uvic-auvic/PCB-Livewire_Control_Board/README.md

# PCB-Livewire_Control_Board
Custom PCB designed by Miguel Manguerra in conjuction with the AUVIC electrical team. The main purpose of the board is to power the coil gun
that shoots torpedos on AUVIC's new submarine.
