uvic-auvic/PCB-Livewire_Control_Board/BOM/BOM/Bill of Materials-RailGun and Grabber Control Board.xlsx

Line # | Name | Description | Designator | Revision ID | Quantity | Manufacturer 1 | Manufacturer Part Number 1 | Manufacturer Lifecycle 1 | Supplier 1 | Supplier Part Number 1 | Supplier Unit Price 1 | Supplier Subtotal 1
 | CL10B104JB8NNNC | CAP CER 0.1UF 50V X7R 0603 | C1, C3, C8, C11, C14, C15, C16, C17, C18, C19 | CMP-00000-3 | 10 | Samsung | CL10B104JB8NNNC | Volume Production
 | CL21B105KBFNNNG | SAMSUNG ELECTRO-MECHANICS - CL21B105KBFNNNG - MLCC CAPACITORS | C2, C12 | CMP-00005-1 | 2 | Samsung | CL21B105KBFNNNG | Volume Production
 | 1uF 50V 0603 SMD, Ceramic | Capacitor, Ceramic, 50V, +/- 10%, 0603 SMD, X5R | C4_Gin1, C4_Gin2, C4_Gin3, C21, C22 | CMP-006-0028-1 | 5 | Samsung | CL10A105KB8NNNC | Volume Production
 | 0.1uF, 50V, 10%, X7R, 1608 | CAP CER 0.1UF 50V 10% X7R 1608 (0603) | C5_Gin1, C5_Gin2, C5_Gin3, C6_Gin1, C6_Gin2, C6_Gin3, C?_Gin1, C?_Gin2, C?_Gin3 | CMP-006-0008-1 | 9 | Samsung | CL10B104KB8SFNC | Volume Production
 | 10uF 50V 1206 SMD, Ceramic | Capacitor, Ceramic, 50V, +/- 10%, 1206 SMD, X5R | C7_Gin1, C7_Gin2, C7_Gin3 | CMP-006-0018-1 | 3 | Samsung | CL31A106KBHNNNE | Volume Production
 | 16pF Ceramic 50V 5% 0603 | Cap Ceramic 16pF 50V C0G 5% SMD 0603 125C Paper T/R | C9, C10 | CMP-00087-2 | 2 | Murata | GRM1885C1H160JA01D | Volume Production
 | 2.2uF, 50V, 0603 SMD, X5R, Ceramic | Capacitor, Ceramic, 50V, 10%, 0603 SMD, X5R | C13 | CMP-006-0030-1 | 1 | Murata | GRM188R61H225KE11D | Volume Production
 | CL31B106KBHNNNE | Cap Ceramic 10uF 50V X7R 10% Pad SMD 1206 125°C T/R | C20 | CMP-00004-1 | 1 | Samsung | CL31B106KBHNNNE | New Product
 | 1x2 Shrouded Right Angle | 02 MTE HDR SRRA LATCH | CN1 | CMP-00010-3 | 1 | TE Connectivity | 5-104935-5 | Volume Production
 | Header, Female, 2x2, RIght Angle, Pitch: 0.118" (3.00mm), THT | Connector Header Through Hole, Right Angle 4 position 0.118" (3.00mm) | CN2_Gin1, CN2_Gin2, CN2_Gin3 | CMP-005-0021-4 | 3 | Molex | 0430450402 | Volume Production
 | ST Debug Header 10-pin THT | CONN HEADER VERT 10POS 2.54MM | CN3 | CMP-00011-6 | 1 | Sullins | SBH11-PBPC-D05-ST-BK | Volume Production
 | Header, Male, 1x4, RA, Pitch 0.1" (2.54mm) | Connector Header Through Hole, Right Angle 4 position 0.100" (2.54mm) | CN4, CN5 | CMP-005-0029-3 | 2 | TE Connectivity | 5-104935-1 | Volume Production
 | 76825-0006 | CONNECTOR, HEADER, 6POS, 2ROW, 5.7MM; Product Range:Mega-Fit 76825 Series; Contact Termination Type:Through Hole; Gender:Header; No. of Contacts:6; Pitch Spacing:5.7mm; Contact Plating:Tin Plated Contacts; Contact Material:Copper | CN6 | CMP-00049-2 | 1 | Molex | 76825-0006 | Volume Production
 | TSSA5U50E3GCT-ND | Diode Schottky 50V 5A Surface Mount DO-214AC (SMA) | D1_Gin1, D1_Gin2, D1_Gin3 | CMP-057-0021-1 | 3 | Taiwan Semiconductor | TSSA5U50 E3G | Unknown
 | LSQ976-NR-1 | LED Red 645nm 2-Pin Chip 0603(1608Metric) T/R | D2 | CMP-00066-2 | 1 | Osram Opto | LSQ976-NR-1 | Volume Production
 | LBQ39E-N1OO-35-1 | LED BLUE DIFFUSED 0603 SMD | D3 | CMP-00063-3 | 1 | Osram Opto | LBQ39E-N1OO-35-1 | Volume Production
 | LT Q39G-Q1OO-25-1 | LED GREEN DIFFUSED 0603 SMD | D4, D6, D7, D8 | CMP-00064-3 | 4 | Osram Opto | LT Q39G-Q1OO-25-1 | Volume Production
 | CUS08F30,H3F | Diode Schottky 30V 800mA Surface Mount USC | D5 | CMP-057-0000-2 | 1 | Toshiba | CUS08F30,H3F | Volume Production
 | SMD Fuse, 2A, 63V, | SMD Fuse, 2A, 63V, | F? | CMP-027-0004-1 | 1 | Bel TRP | C1F2 | Volume Production
 | BLM18AG601SN1D | MURATA - BLM18AG601SN1D - Feritový Korálek, 0603 / 1608, 600 ohm, 500 mA, Série BLM18A, 0.38 ohm, ± 25% | FB1 | CMP-00016-1 | 1 | Murata | BLM18AG601SN1D | Volume Production
 | 1x2 Male Header |  | JP1, JP2, JP3 | CMP-004-0001-1 | 3 | Harwin | M20-9730246 | Volume Production
 | Mount_Hole_3mm | Mounting hold for M3 hex standoff | MH1, MH2, MH3, MH4 | CMP-004-0010-4 | 4
 | MOSFET N-Channel, 40V, 100A, 272W | MOSFET N-Channel, 40V, 100A, 272W, Enh-Mode | Q1_Gin1, Q1_Gin2, Q1_Gin3 | CMP-052-0019-1 | 3 | Nexperia | PSMN1R8-40YLC,115 | Unknown
 | RC0603FR-0733RL | Res Thick Film 0603 33 Ohm 1% 1/10W +/-100ppm/ßC Molded SMD Paper T/R | R1, R3 | CMP-00060-1 | 2 | Yageo | RC0603FR-0733RL | Volume Production
 | RC0603FR-07120RL | Res Thick Film 0603 120 Ohm 1% 0.1W(1/10W) ±100ppm/C Epoxy SMD T/R | R2 | CMP-00061-1 | 1 | Yageo | RC0603FR-07120RL | Volume Production
 | 78.7kR, 1%, 1/10W, 0603 | Res Thick Film 0603 78.7K Ohm 1% 1/10W 100ppm/C Molded SMD SMD Paper T/R | R4_Gin1, R4_Gin2, R4_Gin3 | CMP-00095-1 | 3 | Stackpole Electronics | RMCF0603FT78K7 | Volume Production
 | 100kR, 1%, 1/10W, 0603 SMD | 100kR, 1%, 1/10W, 0603 SMD | R5_Gin1, R5_Gin2, R5_Gin3, R6_Gin1, R6_Gin2, R6_Gin3, R7_Gin1, R7_Gin2, R7_Gin3 | CMP-047-0010-1 | 9 | Yageo | RC0603JR-07100KL | Volume Production
 | 10kR, 1%, 1/10W, 0603 SMD | 10kR, 1%, 1/10W, 0603 SMD | R8_Gin1, R8_Gin2, R8_Gin3, R13, R14, R16, R17, R20, R23, R24, R25 | CMP-047-0013-1 | 11 | Yageo Phycomp | RC0603FR-0710KL | Volume Production
 | 0R005, 1%, 3W, 2512 SMD | 0R005, 1%, 3W, 2512 SMD | R9_Gin1, R9_Gin2, R9_Gin3 | CMP-047-0004-1 | 3 | Bourns | CRE2512-FZ-R005E-3 | Volume Production
 | CRCW0603330RFKEA | Res Thick Film 0603 330 Ohm 1% 0.1W(1/10W) +/-100ppm/ßC Pad SMD Automotive T/R | R10 | CMP-00067-2 | 1 | Vishay | CRCW0603330RFKEA | Volume Production
 | 1kR, 1%, 1/10W , 0603, SMD | 1kR, 1%, 1/10W , 0603, SMD | R11, R26, R27, R28 | CMP-047-0024-1 | 4 | Yageo | RC0603FR-071KL | Volume Production
 | RC0603FR-07110RL | RES SMD 110 OHM 1% 1/10W 0603 | R12, R15, R31 | CMP-00069-1 | 3 | Yageo | RC0603FR-07110RL | Volume Production
 | ERJ-3EKF8252V | RES SMD 82.5K OHM 1% 1/10W 0603 | R18 | CMP-00085-1 | 1 | Panasonic | ERJ-3EKF8252V | Volume Production
 | 16kR, 1%, 1/10W, 0603 SMD | 16kR, 1%, 1/10W, 0603 SMD | R19 | CMP-047-0021-1 | 1 | Yageo | RC0603FR-0716KL | Volume Production
 | RC0603FR-0710KL | Res General Purpose Thick Film 0603 10K Ohm 1% 1/10W ±100ppm/°C Molded SMD Paper T/R | R21 | CMP-00037-1 | 1 | Yageo | RC0603FR-0710KL | Volume Production
 | 27kR, 1%, 1/10W, 0603 | Res Thick Film 0603 27K Ohm 1% 0.1W(1/10W) ±100ppm/C Pad SMD Automotive T/R | R22 | CMP-00090-2 | 1 | TE Connectivity | CRGCQ0603F27K | Unknown
 | CRCW06036K34FKEA | VISHAY CRCW06036K34FKEA. SMD Chip Resistor, Thick Film, 6.34 kohm, 75 V, 0603 [1608 Metric], 100 mW, 1%, CRCW Series | R29 | CMP-00072-1 | 1 | Vishay | CRCW06036K34FKEA | Volume Production
 | ERJ-3EKF5360V | SMD Chip Resistor, 0603 [1608 Metric], 536 ohm, ERJ3EK Series, 75 V, Thick Film, 100 mW | R30 | CMP-00071-1 | 1 | Panasonic | ERJ-3EKF5360V | Volume Production
 | 0R02, 1%, 2W, 2512 SMD | 0R02, 1%, 2W, 2512 SMD | R?_Gin1, R?_Gin2, R?_Gin3 | CMP-047-0006-1 | 3 | TE Connectivity | RLP73V3AR020FTDF | Unknown
 | 80.6kR, 1%, 1/10W, 0603 | Res Thick Film 0603 80.6K Ohm 1% 0.1W(1/10W) ±100ppm/C Molded SMD Automotive Paper T/R | R?_Gin1, R?_Gin2, R?_Gin3 | CMP-00098-1 | 3 | Vishay | CRCW060380K6FKEA | Volume Production
 | PTS645SL43SMTR92LFS | Black Switch Tactile N.O. SPST Round Button Gull Wing 0.05A 12VDC 100000Cycles 1.27N SMD T/R | SW1 | CMP-00077-1 | 1 | ITT C&K | PTS645SL43SMTR92LFS | Volume Production
 | PESD36VS2UT,215 | TVS DIODE 36V 60V SOT23 | TVS1, TVS2 | CMP-058-0000-2 | 2 | Nexperia | PESD36VS2UT,215 | Unknown
 | CAN Transceiver | 1/1 Transceiver Half CANbus 8-SO | U1 | CMP-032-0000-2 | 1 | NXP Semiconductors | TJA1042T/3,118 | Volume Production
 | Op amp 1.8-6V rail-to-rail (SOT23-5) | Op amp 1.8-6V rail-to-rail (SOT23-5) | U2_Gin1, U2_Gin2, U2_Gin3 | CMP-042-0002-1 | 3 | Microchip | MCP6001T-I/OT | Volume Production
 | MIC5014YM-TR | High-Side or Low-Side Gate Driver IC Non-Inverting 8-SOIC | U3_Gin1, U3_Gin2, U3_Gin3 | CMP-028-0000-2 | 3 | Microchip | MIC5014YM-TR | Volume Production
 | STM32F413RGT6 | STMICROELECTRONICS - STM32F413RGT6 - MCU, ARM CORTEX-M4, 100MHZ, LQFP-64 | U4 | CMP-00006-1 | 1 | STMicroelectronics | STM32F413RGT6 | Unknown
 | STM32F413RGT6 | STMICROELECTRONICS - STM32F413RGT6 - MCU, ARM CORTEX-M4, 100MHZ, LQFP-64 | U5 | CMP-00006-2 | 1 | STMicroelectronics | STM32F413RGT6 | Unknown
 | 3.3V 250mA Linear Reg LDO | IC REG LINEAR 3.3V 250MA SOT23-3 | U6 | CMP-00003-1 | 1 | Diodes | AP2138N-3.3TRG1 | Volume Production | Digi-Key | AP2138N-3.3TRG1
 | INA168, Current Sensor, High-Side, Analog | INA168, Current Sensor, High-Side, Analog | U?_Gin1, U?_Gin2, U?_Gin3 | CMP-048-0001-1 | 3 | Texas Instruments | INA168NA/3K | Volume Production
 | CRYSTAL 8.0MHZ 16PF SMD | 8MHz ±30ppm Crystal 16pF 80 Ohms 4-SMD, No Lead | X1 | CMP-00079-2 | 1 | IQD | LFXTAL026380REEL | Volume Production
