uvic-auvic/PCB-Livewire_Control_Board/PDF/RailGun and Grabber Control Board.PDF

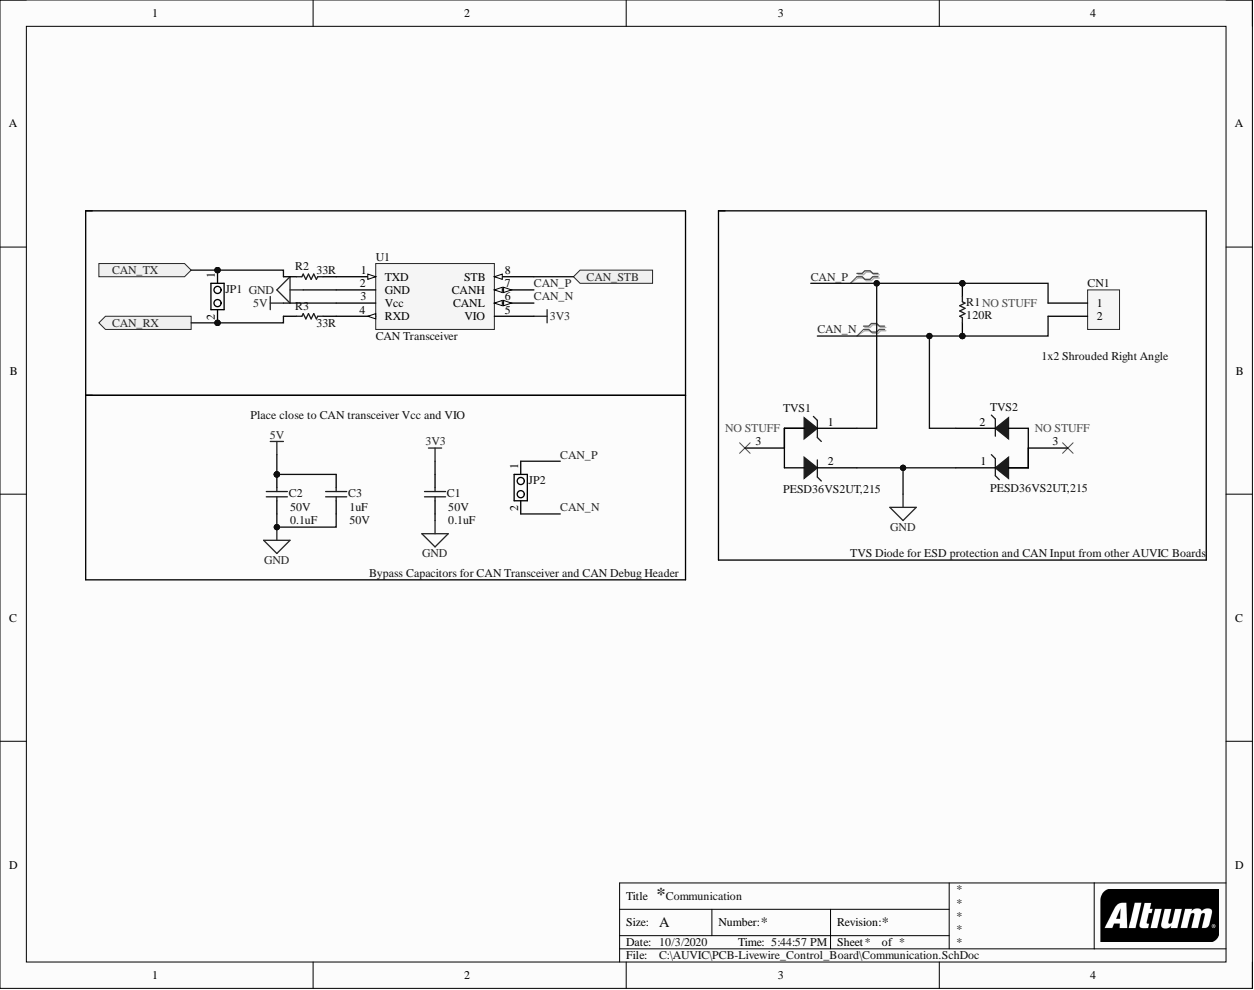
[picture p1: page 1]

Place close to CAN transceiver Vcc and VIO

TVS Diode for ESD protection and CAN Input from other AUVIC Boards

Bypass Capacitors for CAN Transceiver and CAN Debug Header

C:\AUVIC\PCB-Livewire_Control_Board\Communication.SchDoc

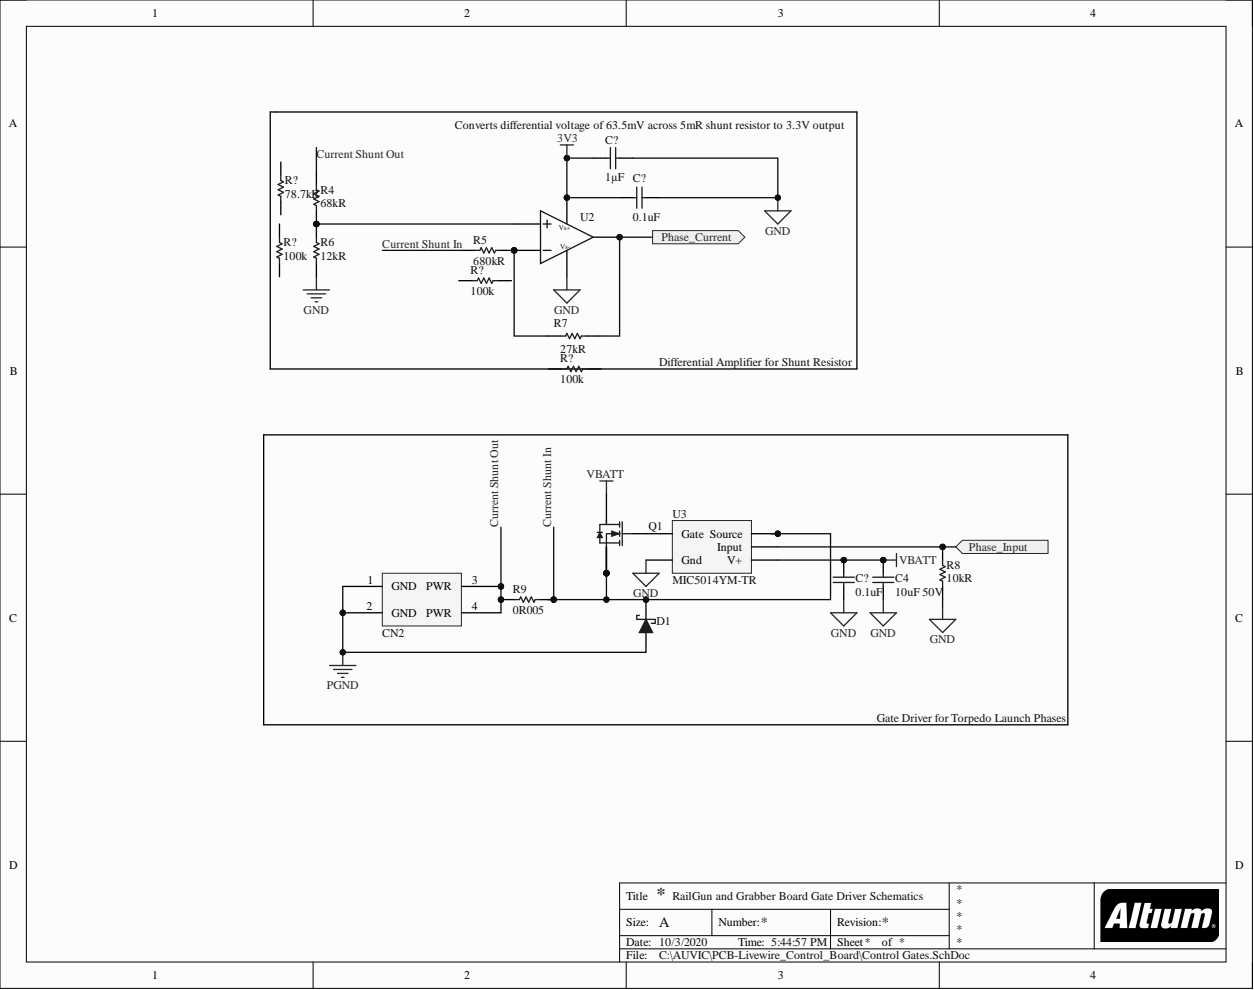
[picture p2: page 2]

Converts differential voltage of 63.5mV across 5mR shunt resistor to 3.3V output

Differential Amplifier for Shunt Resistor

Gate Driver for Torpedo Launch Phases

RailGun and Grabber Board Gate Driver Schematics

C:\AUVIC\PCB-Livewire_Control_Board\Control Gates.SchDoc

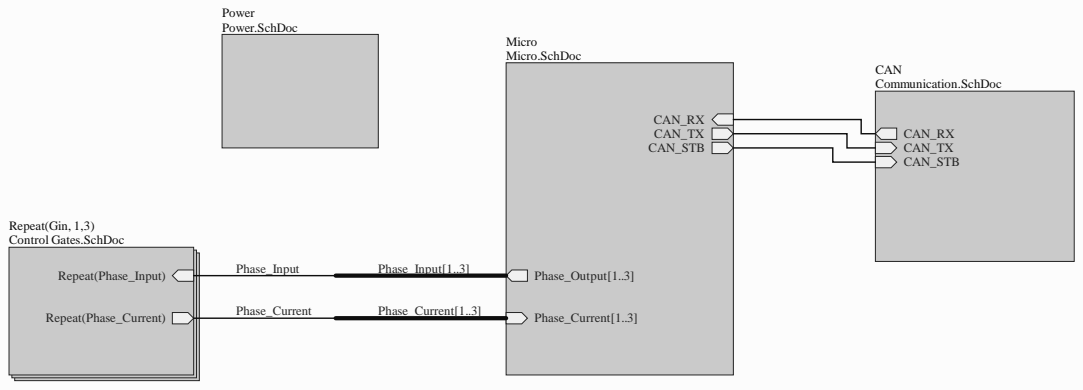
[picture p3: page 3]

C:\AUVIC\PCB-Livewire_Control_Board\Master.SchDoc

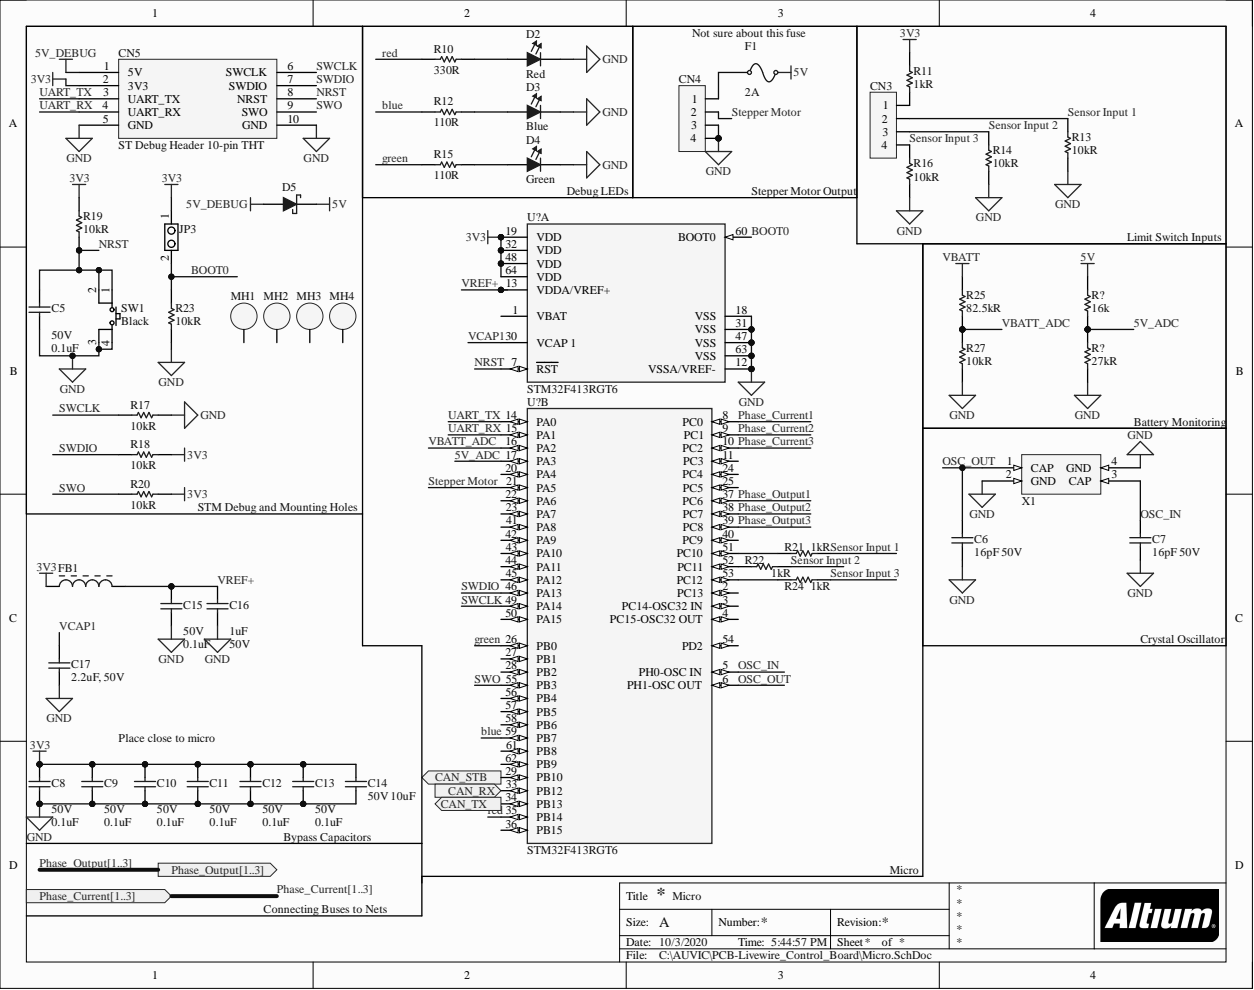
[picture p4: page 4]

Not sure about this fuse

ST Debug Header 10-pin THT

STM Debug and Mounting Holes

Place close to micro

Connecting Buses to Nets

C:\AUVIC\PCB-Livewire_Control_Board\Micro.SchDoc

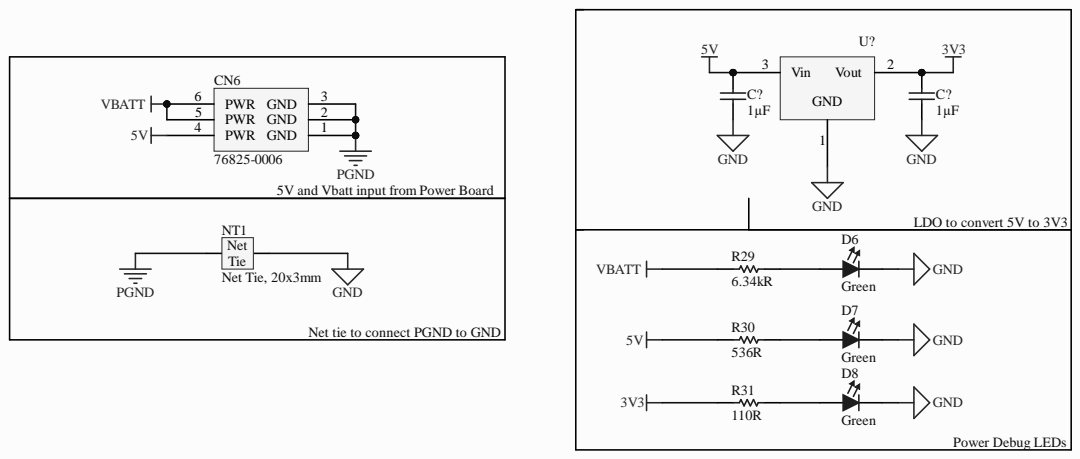
[picture p5: page 5]
