uvic-auvic/PCB-Livewire_Control_Board/(list of files, drawings)

Other design files:
Communication.SchDoc
Control Gates.SchDoc
Master.SchDoc
Micro.SchDoc
Power.SchDoc
RailGun and Grabber PCB.PcbDoc
Railgun Control Board PCB Mk2.0.PcbDoc
Railgun Control Board.PrjPcb
