uvic-auvic/PCB-Livewire_Control_Board/(commit log)

2020-03-20 Initial commit of railgun board
    [CAN Interface.SchDoc, Gate Driver.SchDoc, MicroController.SchDoc, RailGun and Grabber Control Board.PrjPcb, RailGun and Grabber PCB.PcbDoc, UART Interface.SchDoc, Voltage Regulator.SchDoc]
2020-05-13 Schematics Rev 1
    Completed Rev 1 of schematics. Have to be reviewed for further continuation.
    [CAN Interface.SchDoc, Gate Driver.SchDoc, Master.SchDoc, MicroController.SchDoc, RailGun and Grabber Control Board.PrjPcb, UART Interface.SchDoc, Voltage Regulator.SchDoc]
2020-05-13 Small fixes with footprints
    [CAN Interface.SchDoc, Gate Driver.SchDoc, MicroController.SchDoc, RailGun and Grabber Control Board.PrjPcb, RailGun and Grabber PCB.PcbDoc, UART Interface.SchDoc, Voltage Regulator.SchDoc]
2020-05-14 Footprint Fixes
    Added placeholder footprints and fixed other footprints. Added PCB with rooms to start laying components out
    [CAN Interface.SchDoc, Gate Driver.SchDoc, Master.SchDoc, MicroController.SchDoc, RailGun and Grabber Control Board.PrjPcb, RailGun and Grabber PCB.PcbDoc, UART Interface.SchDoc, Voltage Regulator.SchDoc]
2020-05-19 Fixed schematics and footprint problems
    [CAN Interface.SchDoc, Gate Driver.SchDoc, MicroController.SchDoc, RailGun and Grabber PCB.PcbDoc, Voltage Regulator.SchDoc]
2020-06-04 Rev 2 of schematics
    Laid out PCB and added proper footprints for connectors.
    [CAN Interface.SchDoc, Gate Driver.SchDoc, MicroController.SchDoc, RailGun and Grabber Control Board.PrjPcb, RailGun and Grabber PCB.PcbDoc]
2020-06-18 Added proper amount of bypass capacitors
    [CAN Interface.SchDoc, Gate Driver.SchDoc, MicroController.SchDoc, Voltage Regulator.SchDoc]
2020-06-19 init commit
    [RailGun and Grabber Control Board.PrjPcb]
2020-07-10 Updated schematics to use AUVIC components from Altium 365. Restarted PCB layout due to re annotation
    [CAN Interface.SchDoc, Gate Driver.SchDoc, Master.SchDoc, MicroController.SchDoc, RailGun and Grabber PCB.PcbDoc, Voltage Regulator.SchDoc]
2020-08-18 Before I redo PCB
    [CAN Interface.SchDoc, Gate Driver.SchDoc, Master.SchDoc, MicroController.SchDoc, RailGun and Grabber Control Board.PrjPcb, RailGun and Grabber PCB.PcbDoc, Voltage Regulator.SchDoc]
2020-08-21 Response and changes based on poorna's comments
    [CAN Interface.SchDoc, Gate Driver.SchDoc, MicroController.SchDoc, RailGun and Grabber PCB.PcbDoc, Voltage Regulator.SchDoc]
2020-09-07 Added Current Shunt sensing and PWM outputs for gate driver functionality. Also added connector for stepper motor with current limiting fuse. Also added voltage dividers to monitor battery voltage an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
    [Gate Driver.SchDoc, Master.SchDoc, MicroController.SchDoc, RailGun and Grabber PCB.PcbDoc, Voltage Regulator.SchDoc]
2020-09-21 Renamed schematics and added current sensing features
    [Communication.SchDoc, Control Gates.SchDoc, Master.SchDoc, Micro.SchDoc, Power.SchDoc, RailGun and Grabber PCB.PcbDoc]
2020-09-21 Deleting old schematics
    [CAN Interface.SchDoc, Gate Driver.SchDoc, MicroController.SchDoc, Voltage Regulator.SchDoc]
2020-09-21 Added Current Sensing and control features to Control Gates. Fixed tiny mistakes poorna noticed. Changed 3V3 LDO to supply 500mA instead of 250mA. Also reorganized each schematic for better readabili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
    [Communication.SchDoc, Control Gates.SchDoc, Master.SchDoc, Micro.SchDoc, Power.SchDoc, RailGun and Grabber PCB.PcbDoc]
2020-10-02 Changed to different micro with better package
    [Control Gates.SchDoc, Micro.SchDoc, Power.SchDoc, RailGun and Grabber PCB.PcbDoc]
2020-10-04 Experimenting with new gitignore
    Also changed Op amp circuit and microcontroller package
    [Communication.SchDoc, Control Gates.SchDoc, Micro.SchDoc, Power.SchDoc, RailGun and Grabber Control Board.PrjPcb]
2020-10-04 Removing history
    [Micro.SchDoc]
2020-10-04 html doc gone from project
    [RailGun and Grabber Control Board.PrjPcb]
2020-10-14 Finalizing Micro changes and control gate changes. Drew schematics for both differential amplifier and ina168 current sensor depending on which one we use.
    [Control Gates.SchDoc, Master.SchDoc, Micro.SchDoc, RailGun and Grabber PCB.PcbDoc]
2020-10-15 Made small changes
    [Communication.SchDoc, Control Gates.SchDoc, Micro.SchDoc, Power.SchDoc]
2020-10-18 Begun PCB Layout and changed Stepper Motor connector from 4 to 3 pin connector
    [Control Gates.SchDoc, Master.SchDoc, Micro.SchDoc, Power.SchDoc, RailGun and Grabber PCB.PcbDoc]
2020-11-05 PCB component placement done. Almost finished routing
    [Communication.SchDoc, Control Gates.SchDoc, Master.SchDoc, Micro.SchDoc, Power.SchDoc, RailGun and Grabber Control Board.PrjPcb]
2020-11-06 Changed micro schematic arrangement
    [Livewire Control Board.PrjPcb, Micro.SchDoc]
2020-11-13 Finished Mk1.0 PCB
    [RailGun and Grabber Control Board.PrjPcb]
2020-11-20 Renamed from Railgun and Grabber -> Railgun Control Board
    [RailGun and Grabber Control Board.PrjPcb, Railgun Control Board.PrjPcb]
2020-11-20 Changed PCB name on silkscreen
2020-11-20 Added debug silkscreen text for power lines
2020-11-26 Removed old project
    [Bill of Materials-RailGun and Grabber Control Board.xlsx, Livewire Control Board.PrjPcb]
2020-11-26 Reorganized naming
    [Railgun Control Board.PrjPcb]
2020-11-26 added BOM
    [Railgun Control Board.PrjPcb]
2020-12-05 Finished 4 layer Mk2.0 PCB
    [Communication.SchDoc, Control Gates.SchDoc, Micro.SchDoc, Power.SchDoc, Railgun Control Board.PrjPcb]
2020-12-11 Finished revising MK2.0 PCB
    [Control Gates.SchDoc, Micro.SchDoc]
2020-12-12 Outputted Gerber Files
    [Railgun Control Board PCB Mk2.0.GBL, Railgun Control Board PCB Mk2.0.GBO, Railgun Control Board PCB Mk2.0.GBP, Railgun Control Board PCB Mk2.0.GBS, Railgun Control Board PCB Mk2.0.GKO, Railgun Control Board PCB Mk2.0.GM1, Railgun Control Board PCB Mk2.0.GTL, Railgun Control Board PCB Mk2.0.GTO]
